Ruike-Yan/densor_Ruike/techinical_assignment_eport/Concept Diagram.jpg

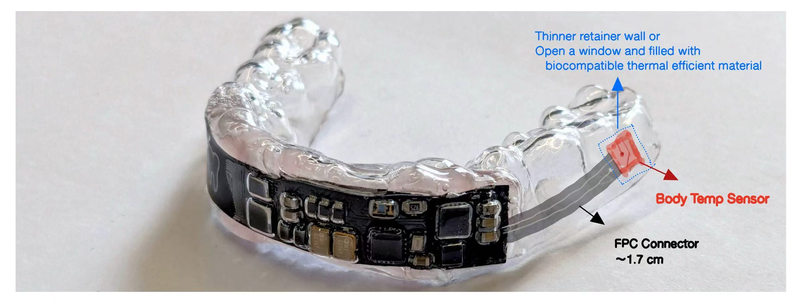
techinical_assignment_eport/Concept Diagram.jpg
