Ruike-Yan/densor_Ruike/techinical_assignment_eport/PCB Layout Zoomed.png

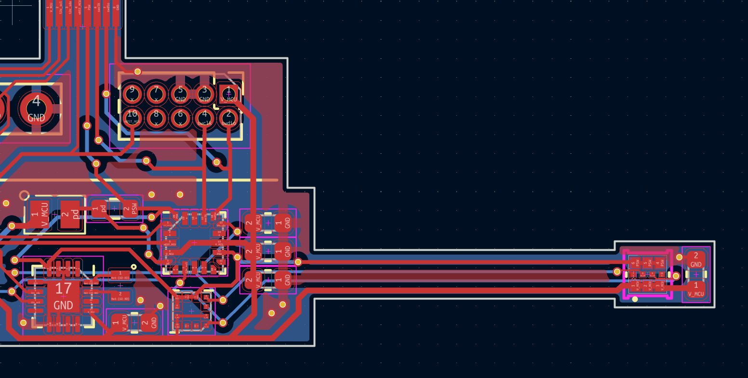
techinical_assignment_eport/PCB Layout Zoomed.png
