Ruike-Yan/densor_Ruike/techinical_assignment_eport/Circuit Schematic.pdf

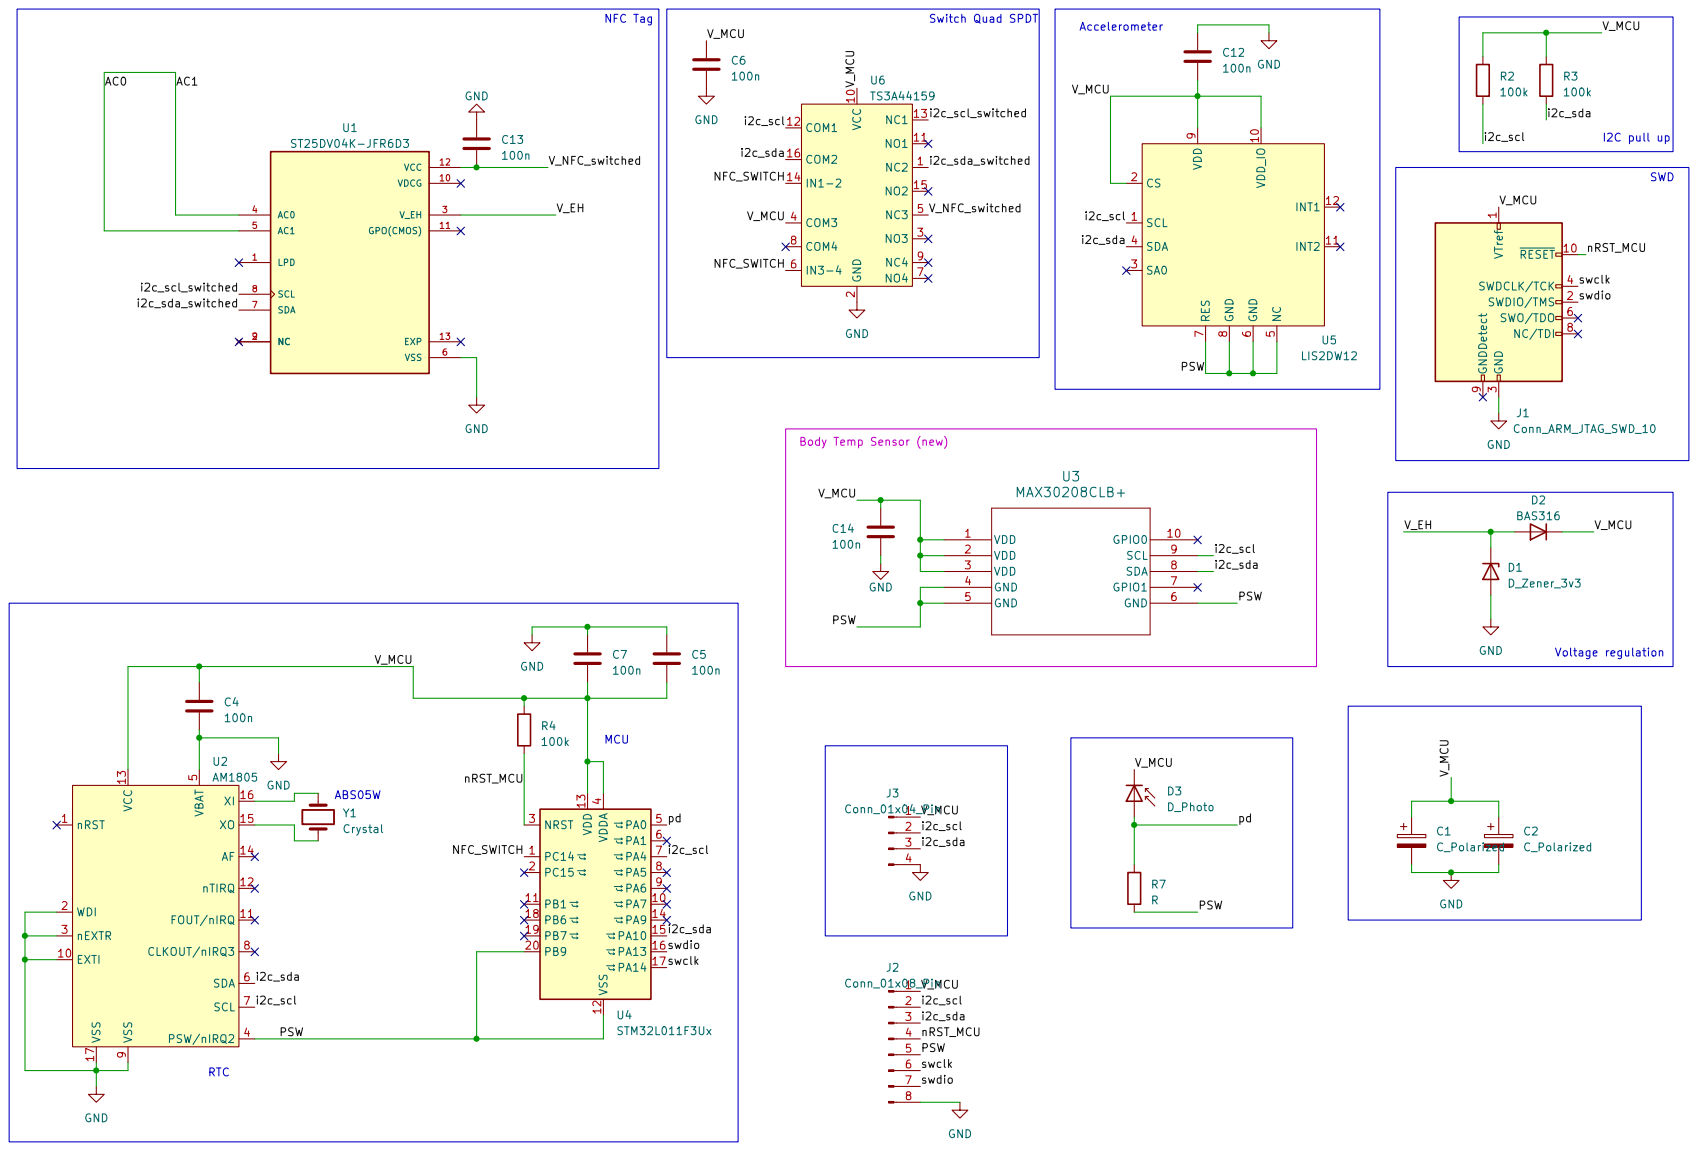
[picture p4: page 1]
