Ruike-Yan/densor_Ruike/NFC_harvester_battery_free/hardware/Densor_kicad_project/densor_nfc_v2.kicad_pcb

## KiCad design NFC_harvester_battery_free/hardware/Densor_kicad_project/densor_nfc_v2.kicad_pcb (2026-08-19)

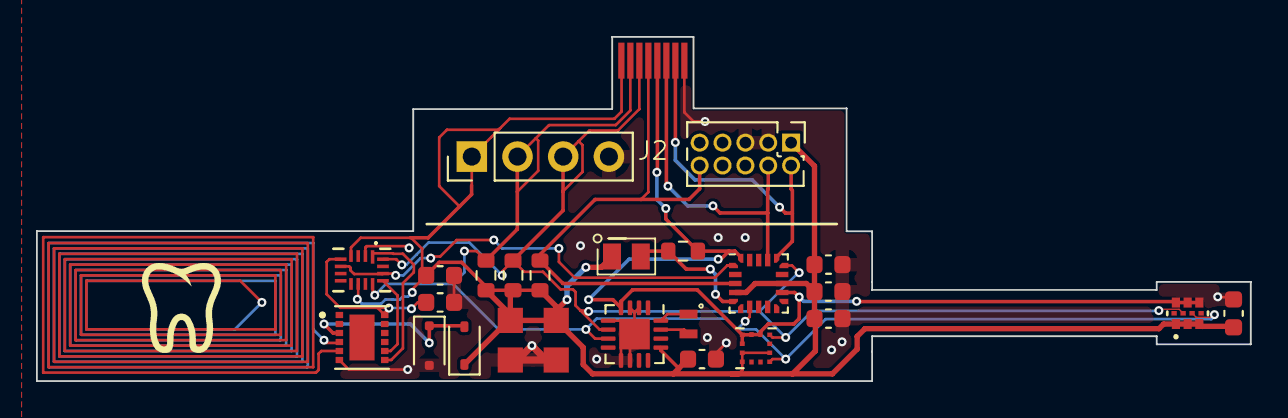
[picture p5: board densor_nfc_v2.kicad_pcb from above]

Board: 2 copper layers, 67.4 x 19.1 mm, 26 parts (0 on the bottom side), 17 nets.

Parts:
C1, C2: C_Polarized; CPX3225A
C4, C5, C6, C7, C12, C13, C14: 100n; C_0603_1608Metric
D1: D_Zener_3v3; D_SOD-323F
D2: BAS316; D_SOD-323
D3: D_Photo; pd_vemd1060x01
J1: Conn_ARM_JTAG_SWD_10; PinHeader_2x05_P1.27mm_Vertical
J2: Conn_01x08_Pin; fpc_503480-0800
J3: Conn_01x04_Pin; PinHeader_1x04_P2.54mm_Vertical
R2, R3, R4: 100k; R_0603_1608Metric
R7: R; R_0603_1608Metric
U1: ST25DV04K-JFR6D3; PSON50P300X300X60-13N
U2: AM1805; QFN-16-1EP_3x3mm_P0.5mm_EP1.7x1.7mm
U3: MAX30208CLB+; 21-100265_MXM
U4: STM32L011F3Ux; ST_UFQFPN-20_3x3mm_P0.5mm
U5: LIS2DW12; Kionix_LGA-12_2x2mm_P0.5mm_LayoutBorder2x4y
U6: TS3A44159; RSV16
Y1: Crystal; ABS05W_Crystal

Connections:
/AC0: U1.4 (AC0), U1.5 (AC1)
/NFC_SWITCH: U4.1 (PC14), U6.6 (IN3-4), U6.14 (IN1-2)
/PSW: J2.5, R7.2, U2.4 (PSW/nIRQ2), U3.4 (GND), U3.5 (GND), U3.6 (GND), U4.12 (VSS), U4.20 (PB9), U5.5 (NC), U5.6 (GND), U5.7 (RES), U5.8 (GND)
/V_EH: D1.1 (K), D2.2 (A), U1.3 (V_EH)
/V_MCU: C1.1, C2.1, C4.1, C5.2, C6.1, C7.2, C12.2, C14.1, D2.1 (K), D3.1 (K), J1.1 (VTref), J2.1, J3.1, R2.1, R3.1, R4.1, U2.13 (VCC), U3.1 (VDD), U3.2 (VDD), U3.3 (VDD), U4.4 (VDDA), U4.13 (VDD), U5.2 (CS), U5.9 (VDD), U5.10 (VDD_IO), U6.4 (COM3), U6.10 (VCC)
/V_NFC_switched: C13.2, U1.12 (VCC), U6.5 (NC3)
/i2c_scl: J2.2, J3.2, R2.2, U2.7 (SCL), U3.9 (SCL), U4.7 (PA4), U5.1 (SCL), U6.12 (COM1)
/i2c_scl_switched: U1.8 (SCL), U6.13 (NC1)
/i2c_sda: J2.3, J3.3, R3.2, U2.6 (SDA), U3.8 (SDA), U4.15 (PA10), U5.4 (SDA), U6.16 (COM2)
/i2c_sda_switched: U1.7 (SDA), U6.1 (NC2)
/nRST_MCU: J1.10 (~RESET), J2.4, R4.2, U4.3 (NRST)
/pd: D3.2 (A), R7.1, U4.5 (PA0)
/swclk: J1.4 (SWDCLK/TCK), J2.6, U4.17 (PA14)
/swdio: J1.2 (SWDIO/TMS), J2.7, U4.16 (PA13)
GND: C1.2, C2.2, C4.2, C5.1, C6.2, C7.1, C12.1, C13.1, C14.2, D1.2 (A), J1.3 (GND), J1.5 (GND), J2.8, J3.4, U1.6 (VSS), U2.2 (WDI), U2.3 (nEXTR), U2.5 (VBAT), U2.9 (VSS), U2.10 (EXTI), U2.17 (VSS), U6.2 (GND)
unnamed: U2.16 (XI), Y1.1
unnamed: U2.15 (XO), Y1.2
