Ruike-Yan/densor_Ruike/techinical_assignment_eport/Compile Result.png

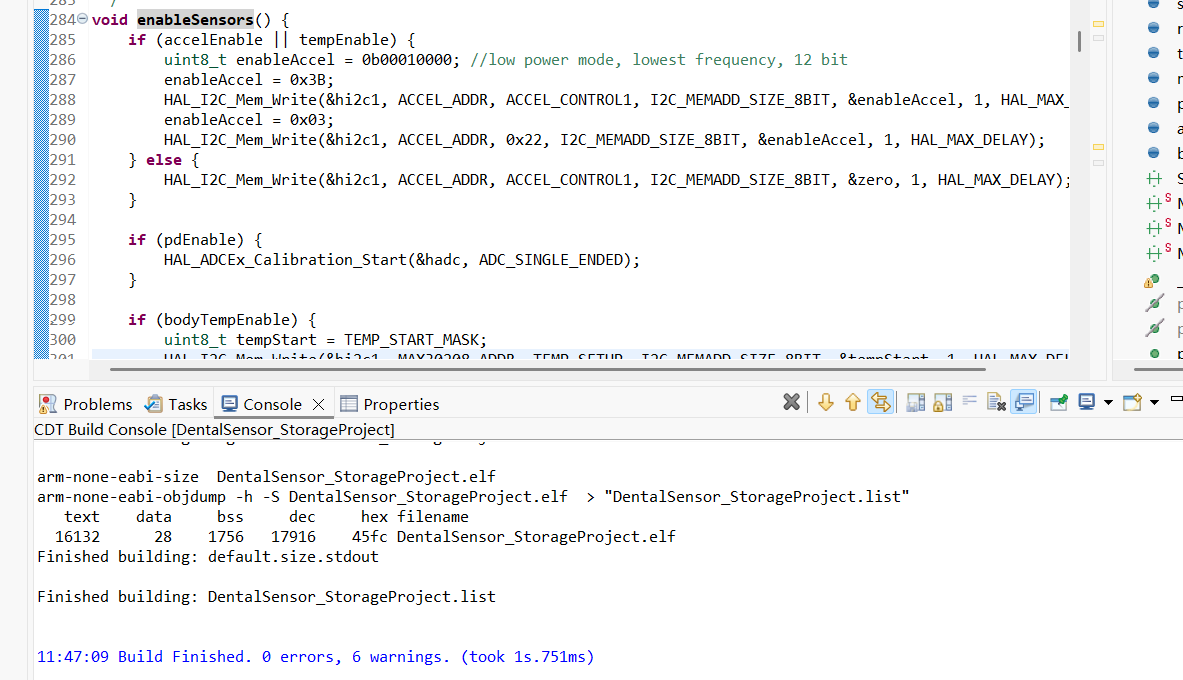
techinical_assignment_eport/Compile Result.png
