Ruike-Yan/densor_Ruike/(commit log)

2026-08-19 Schematics finished
    [densor_nfc_v2.kicad_pcb, densor_nfc_v2.kicad_sch]
2026-08-19 Schemetics and PCB layout finished
    Concept diagram added
    [densor_nfc_v2.kicad_pcb, densor_nfc_v2.kicad_sch]
